TeleportingSkunk/vdx-gimbal/images/Selection_001.png

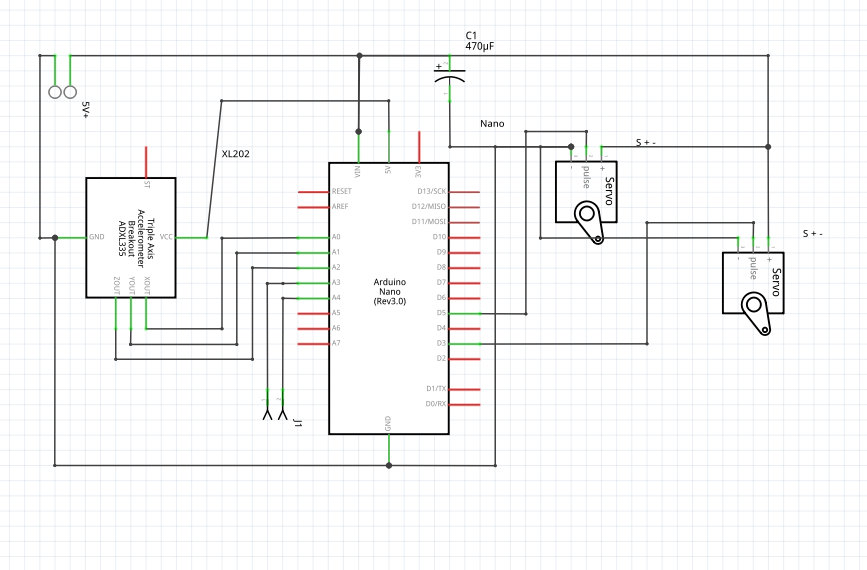
images/Selection_001.png
