TeleportingSkunk/vdx-gimbal/images/Selection_002.png

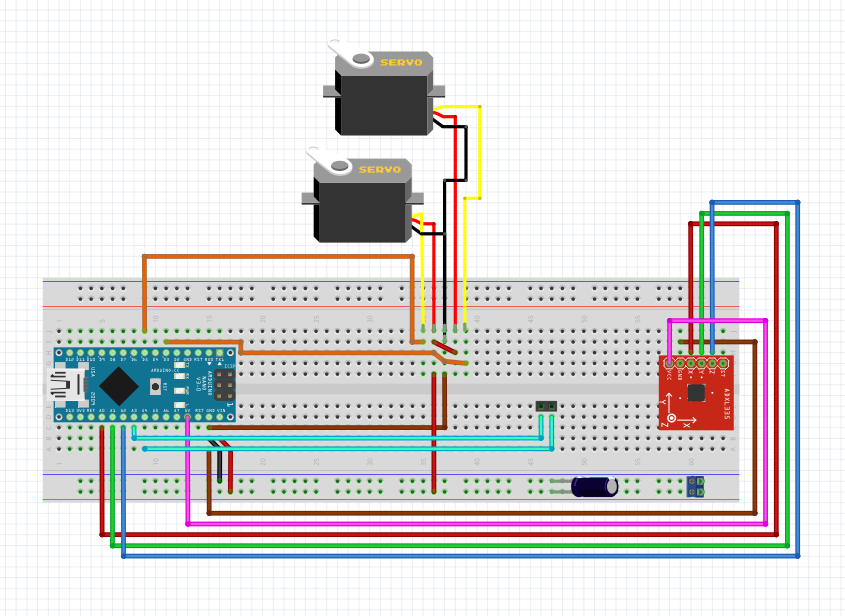
images/Selection_002.png
