TeleportingSkunk/vdx-gimbal/(commit log)

2018-03-19 Added the MikroeAccel202 and mean filter libraries
2018-03-19 Added circuit and breadboard images
2018-03-19 removed brackets
